CrazyChip/mk2/README.md

# mk2
===
MkII clone with LUFA firmware.

### Features:
* ISP-10, ISP-6, PDI, TPI connectors
* Atmega16U2 based
* 3.3V - 5V selector
* uses Atmega's internal 3.3V regulator (no external regulator)
* no output buffer, minimal number of parts
