CrazyChip/mk2/BOM.md

| No | Designator | Package | Quantity | Designation | Price | Supplier's ref |
| ---- | ---- | ---- | ---- | ---- | ---- | ---- |
| 1 | J1 | USB_B | 1 | USB | 1.5 | CLI812 |
| 2 | IC1 | TQFP32 | 1 | ATMEGA16U2 | 15.06 | 7153791 |
| 3 | R7,R8 | SM1206 | 2 | 220 | 0.1 | RM222 |
| 4 | R4,R3 | SM1206 | 2 | 10K | 0.1 | RM410 |
| 5 | R5,R6 | SM1206 | 2 | 1K | 0.1 | RM310 |
| 6 | C6 | SM1206 | 1 | 100nF | 0.15 | KM510X6 |
| 7 | C3,C2 | SM1206 | 2 | 22 | 0.1 | KM122N6 |
| 8 | R2,R1 | SM1206 | 2 | 22 | 0.1 | RM122 |
| 9 | C4 | SM1206 | 1 | 1uF | 0.2 | KM610Y6 |
| 10 | CON4 | PIN_ARRAY_5x2 | 1 | AVR-ISP-10 | 1.8 | CJK4402 |
|  | CON3 | PIN_ARRAY_3x2 | 1 | AVR-TPI-6 |  |  |
|  | CON2 | PIN_ARRAY_3x2 | 1 | AVR-PDI-6 |  |  |
|  | CON1 | PIN_ARRAY_3x2 | 1 | AVR-ISP-6 |  |  |
|  | JP1 | PIN_ARRAY_3X1 | 1 | 5v/3.3v |  |  |
|  | JP2 | PIN_ARRAY_2X1 | 1 | SELF_PROG |  |  |
| 11 | D2 | LED-1206 | 1 | red | 0.2 | PLDKS06G |
| 12 | D1 | LED-1206 | 1 | green | 0.25 | PLDKS06ZS |
| 13 | X1 | HC-18UV | 1 | 8MHz | 1.9 | QK08M |
| 14 | SW1,SW2 | D3 | 2 | HWB,RST buttons | 0.5 | CPR024 |
| 15 | C1 | C1V5 | 1 | 10uF | 0.1 | KE10/6 |
| 16 | JP | JUMPER | 2 | SELECTOR | 0.1 | CJT5R |
