CrazyChip/mk2/kicad/mk2.pdf

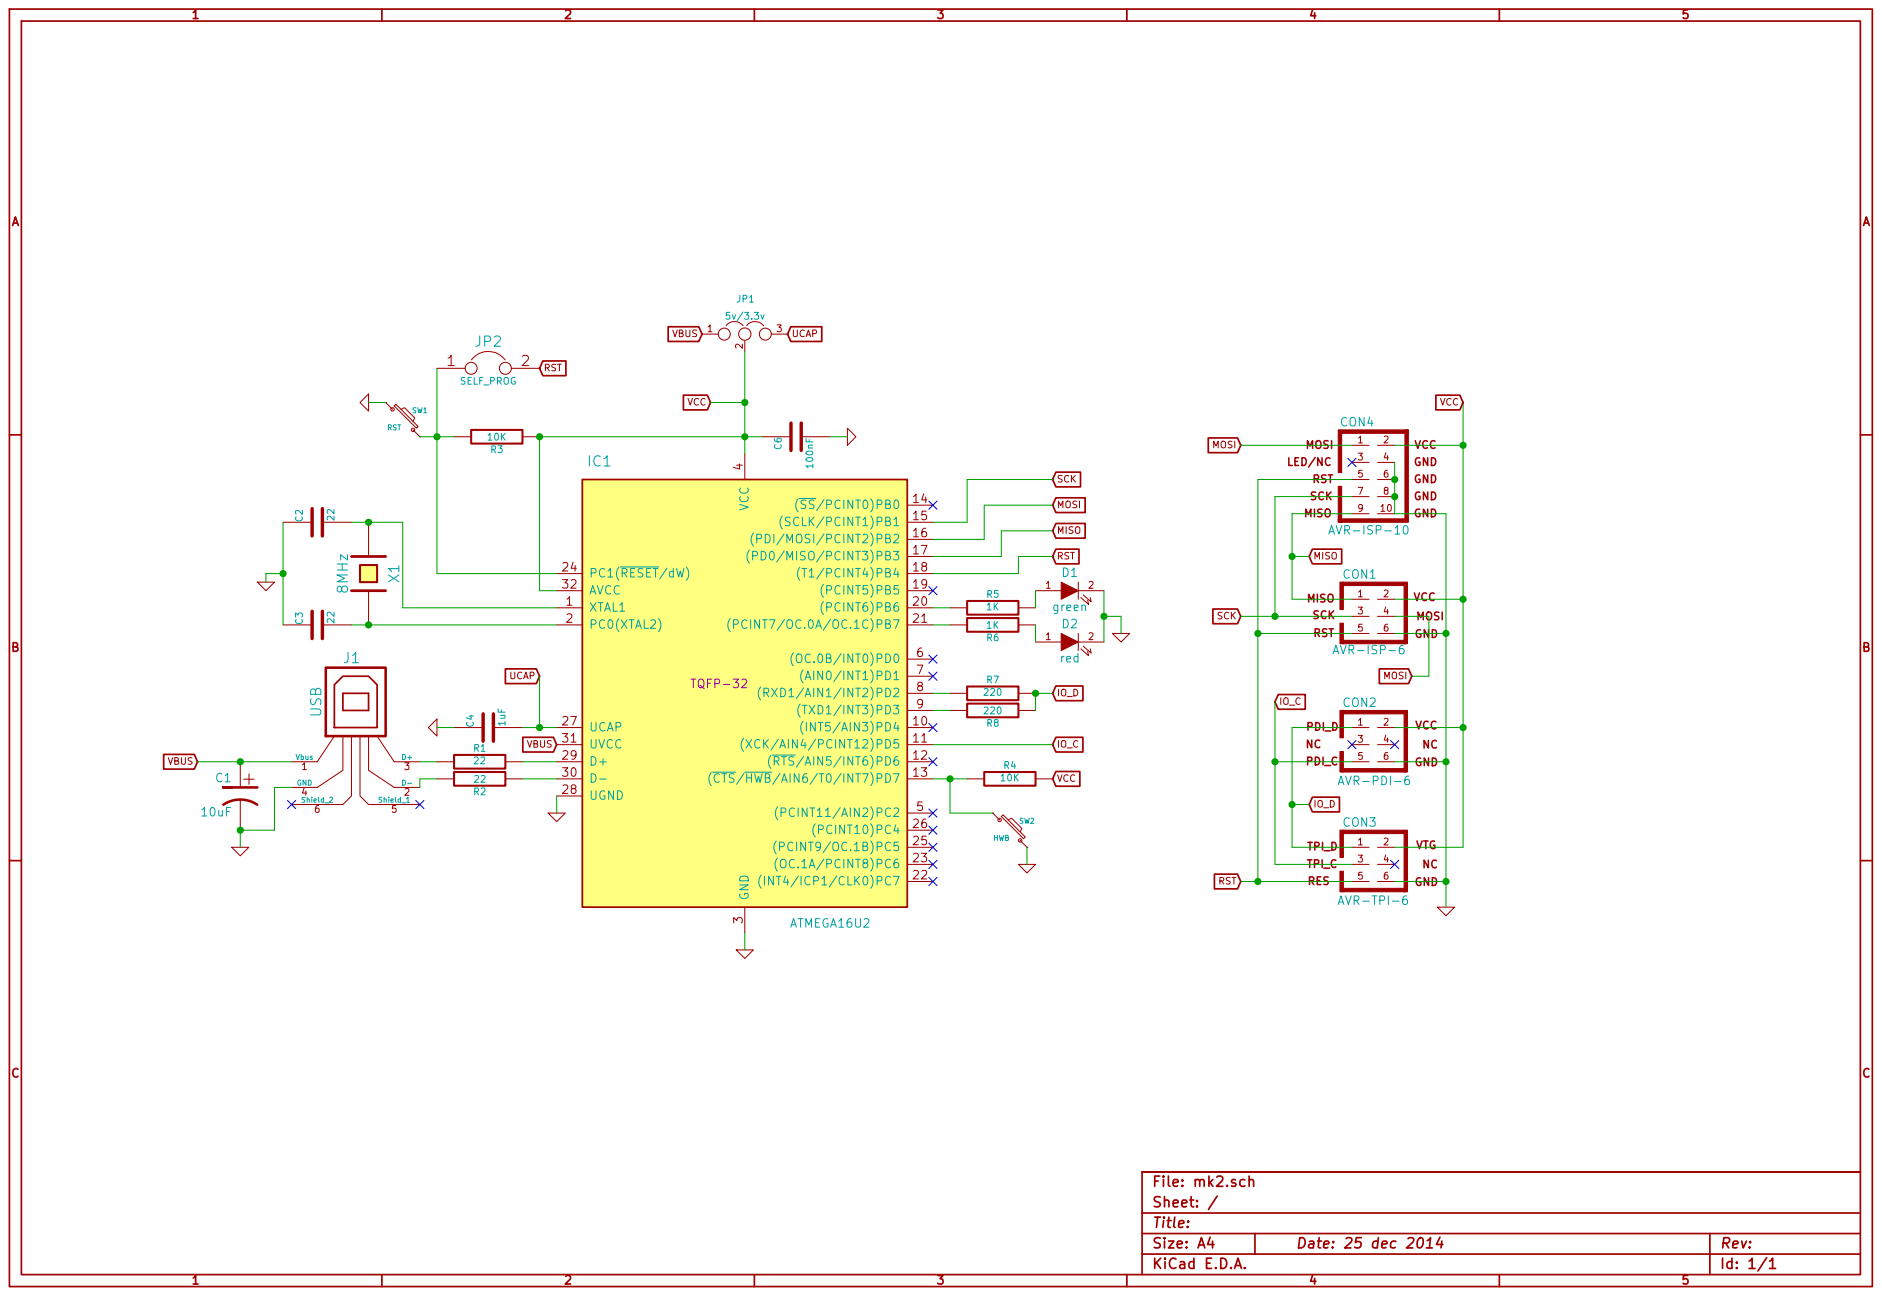
[picture p1: page 1]

VCC GND GND GND

Id: 1/1 Title: File: mk2.sch Sheet: /
