CrazyChip/mk2/kicad/PCB.pdf

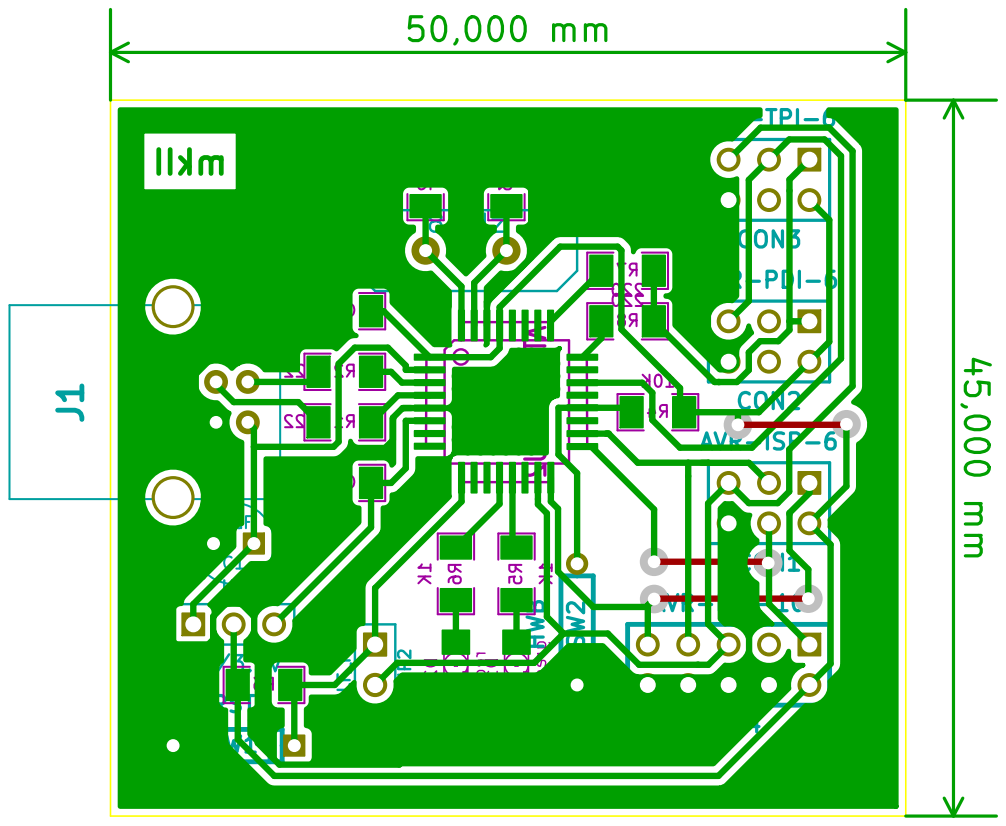
[picture p2: page 1]
