CrazyChip/mk2/kicad/mk2.kicad_pcb

## KiCad design kicad/mk2.kicad_pcb (2014-12-27)

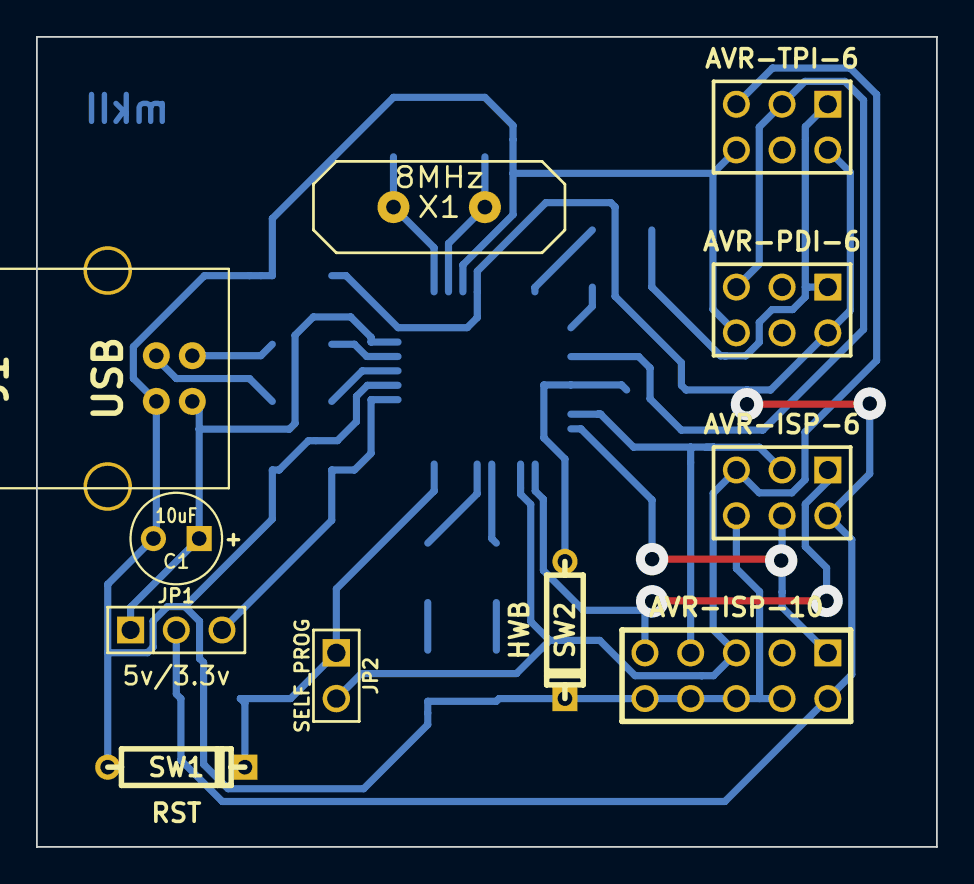
[picture p3: board mk2.kicad_pcb from above]

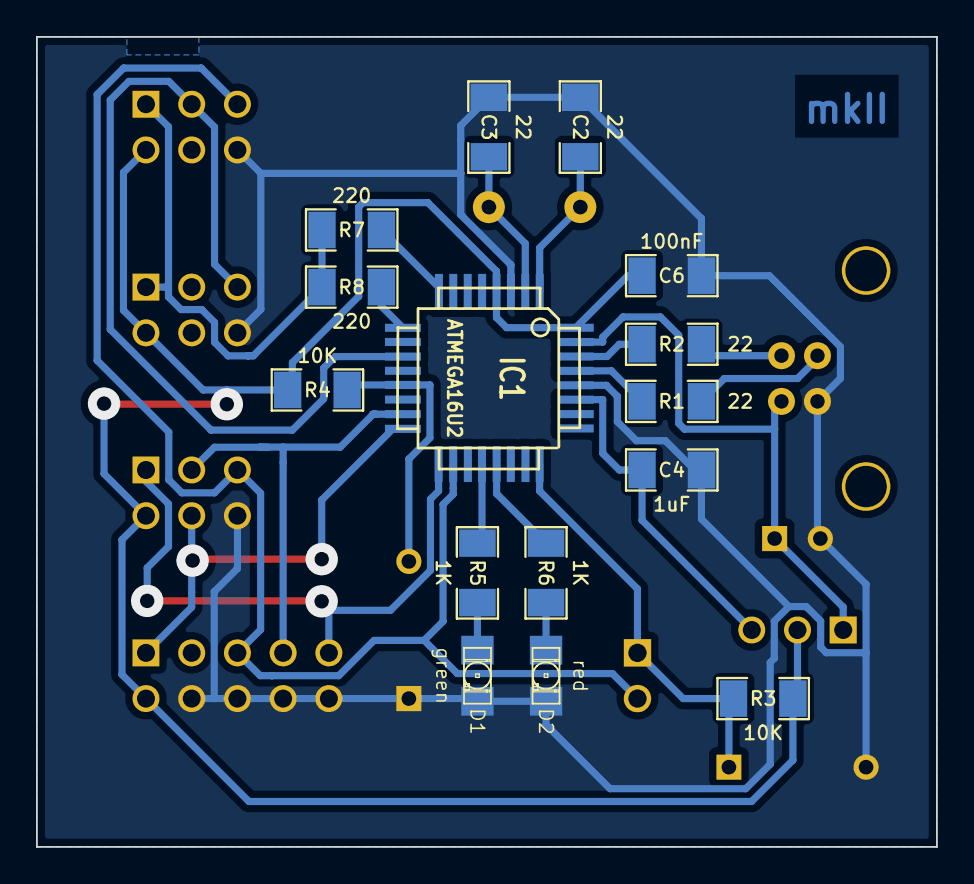
[picture p4: board mk2.kicad_pcb from below]

Board: 2 copper layers, 50.0 x 45.0 mm, 26 parts (15 on the bottom side), 24 nets.

Parts:
C1: 10uF; C1V5
C2, C3: 22; SM1206
C4: 1uF; SM1206
C6: 100nF; SM1206
CON1: AVR-ISP-6; pin_array_3x2
CON2: AVR-PDI-6; pin_array_3x2
CON3: AVR-TPI-6; pin_array_3x2
CON4: AVR-ISP-10; PIN_ARRAY_5x2
D1: green; LED-1206
D2: red; LED-1206
IC1: ATMEGA16U2; TQFP32
J1: USB; USB_B
JP1: 5v/3.3v; PIN_ARRAY_3X1
JP2: SELF_PROG; PIN_ARRAY_2X1
R1, R2: 22; SM1206
R3, R4: 10K; SM1206
R5, R6: 1K; SM1206
R7, R8: 220; SM1206
SW1: RST; D3
SW2: HWB; D3
X1: 8MHz; HC-18UV

Connections:
GND: C1.2, C2.1, C3.1, C4.1, C6.2, CON1.6, CON2.6, CON3.6, CON4.4, CON4.6, CON4.8, CON4.10, D1.2, D2.2, IC1.3, IC1.28, J1.4, SW1.1, SW2.2
IO_C: CON2.5, CON3.3, IC1.11
IO_D: CON2.1, CON3.1, R7.2, R8.2
MISO: CON1.1, CON4.9, IC1.17
MOSI: CON1.4, CON4.1, IC1.16
unnamed: IC1.21, R6.1
unnamed: IC1.20, R5.1
unnamed: IC1.9, R8.1
unnamed: IC1.8, R7.1
unnamed: D2.1, R6.2
unnamed: D1.1, R5.2
unnamed: J1.2, R2.2
unnamed: J1.3, R1.1
unnamed: IC1.30, R2.1
unnamed: IC1.29, R1.2
unnamed: IC1.24, JP2.1, R3.1, SW1.2
unnamed: IC1.13, R4.1, SW2.1
unnamed: C2.2, IC1.1, X1.2
unnamed: C3.2, IC1.2, X1.1
RST: CON1.5, CON3.5, CON4.5, IC1.18, JP2.2
SCK: CON1.3, CON4.7, IC1.15
UCAP: C4.2, IC1.27, JP1.3
VBUS: C1.1, IC1.31, J1.1, JP1.1
VCC: C6.1, CON1.2, CON2.2, CON3.2, CON4.2, IC1.4, IC1.32, JP1.2, R3.2, R4.2
