CrazyChip/mk2/(commit log)

2014-12-23 Update BOM.md
    fix table
2014-12-23 Update BOM.md
    fix 2
2014-12-23 BOM updated
    added SMD resistor
2014-12-24 schematic
    initial schematic, Atmega and USB connections
    [mk2.sch]
2014-12-24 BOM
    bom fix3
2014-12-25 initial schematic
    Schematic with FET output buffer
    [mk2.sch]
2014-12-26 updated schematic
    Removed output buffers and external 3.3V regulator
    Crystal changed to 8MHz
    Pullups changed to 10K
    Added jumper for self-programming
    [mk2.sch]
2014-12-26 BOM updated
    removed some parts
2014-12-26 PCB
    One-sided PCB prepared
    [mk2.kicad_pcb]
2014-12-27 final BOM
    Full list of materials
2014-12-27 BOM updated
    jumpers added
2014-12-27 PCB update
    Updated silkscreen
    [mk2.kicad_pcb]
